davidmolony/HVDCDC/README.md

# HVDCDC
Hardware and firmware for stm32G030F6 based DCDC converter
