davidmolony/HVDCDC/HVDCDC/HVDCDC.pdf

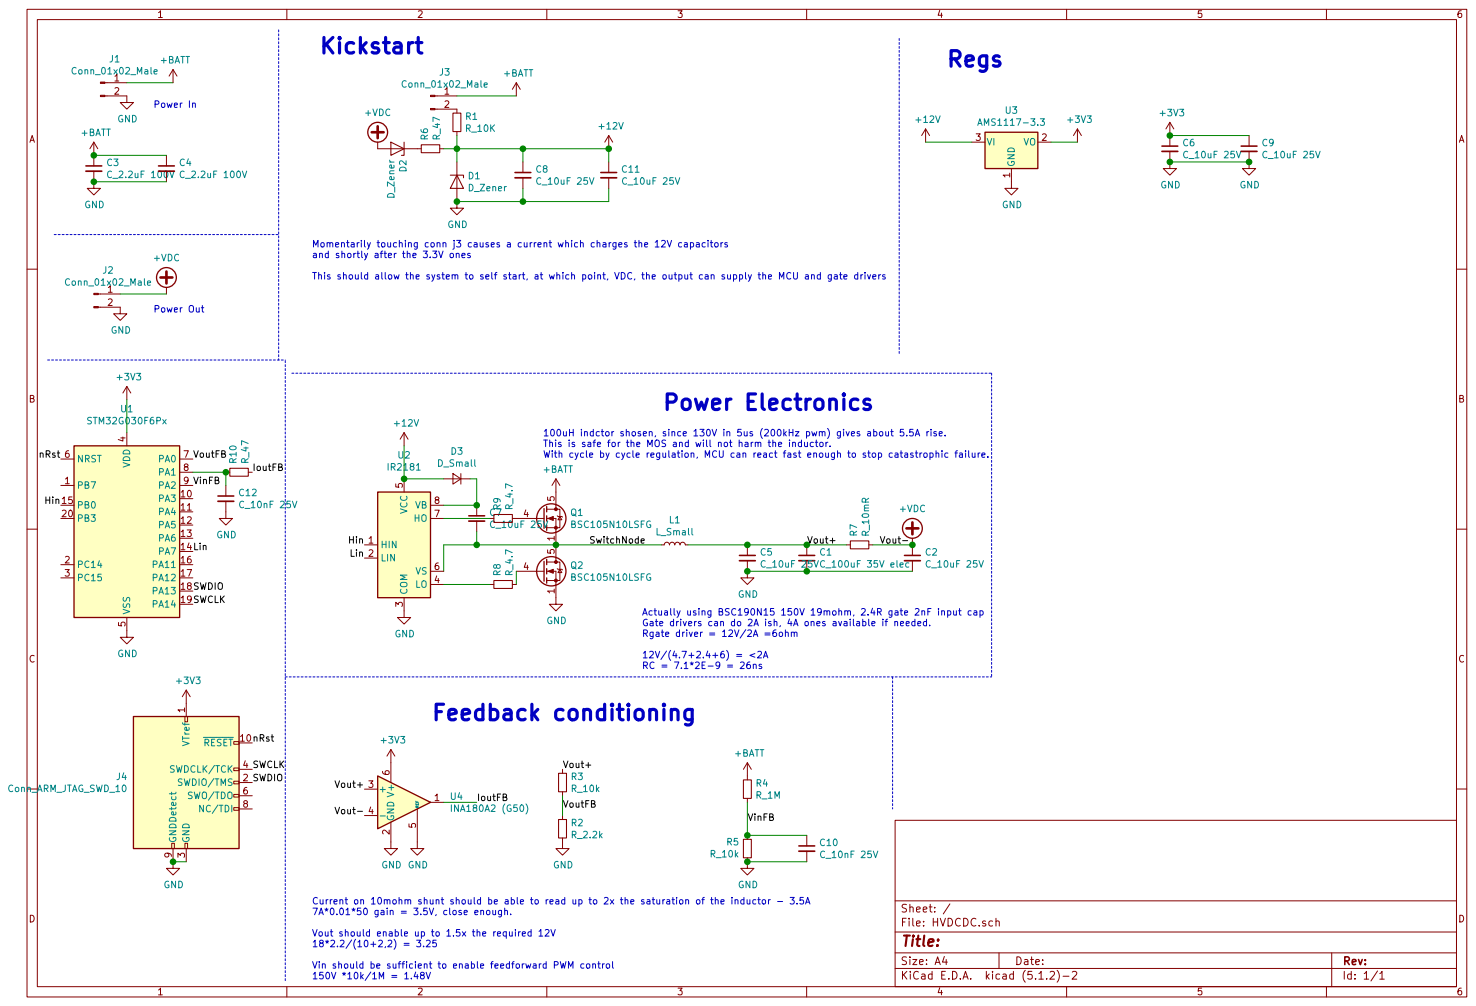
[picture p1: page 1]

Momentarily touching conn j3 causes a current which charges the 12V capacitors
and shortly after the 3.3V ones

12V/(4.7+2.4+6) = <2A RC = 7.1*2E-9 = 26ns 100uH indctor shosen, since 130V in 5us (200kHz pwm) gives about 5.5A rise. This is safe for the MOS and will not harm the inductor. With cycle by cycle regulation, MCU can react fast enough to stop catastrophic failure. R10 R_47 C12 C_10nF 25V GND

Actually using BSC190N15 150V 19mohm, 2.4R gate 2nF input cap Gate drivers can do 2A ish, 4A ones available if needed. Rgate driver = 12V/2A =6ohm

3 SWDCLK/TCK 4 SWO/TDO 6 NC/TDI 8 GNDDetect 9

Current on 10mohm shunt should be able to read up to 2x the saturation of the inductor - 3.5A
7A*0.01*50 gain = 3.5V, close enough.

Id: 1/1 Title: File: HVDCDC.sch Sheet: /

Vout should enable up to 1.5x the required 12V
18*2.2/(10+2,2) = 3.25 Vin should be sufficient to enable feedforward PWM control 150V *10k/1M = 1.48V
