davidmolony/HVDCDC/HVDCDC/HVDCDC.kicad_pcb

## KiCad design HVDCDC/HVDCDC.kicad_pcb (2023-01-25)

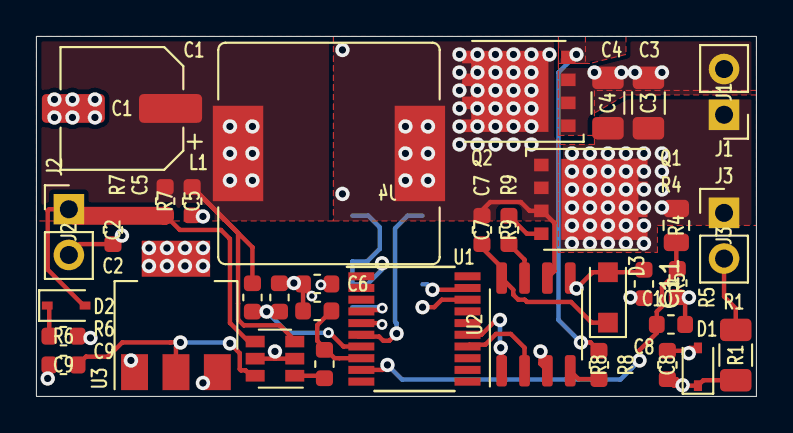
[picture p2: board HVDCDC.kicad_pcb from above]

Board: 4 copper layers, 40.0 x 20.0 mm, 36 parts (1 on the bottom side), 23 nets.

Parts:
C1: C_100uF 35V elec; CP_Elec_6.3x7.7
C2, C5, C6, C7, C8, C9, C11: C_10uF 25V; C_0603_1608Metric
C3, C4: C_2.2uF 100V; C_1206_3216Metric
C10, C12: C_10nF 25V; C_0603_1608Metric
D1, D2: D_Zener; D_SOD-323
D3: D_Small; D_SOD-123F
J1, J2, J3: Conn_01x02_Male; PinHeader_1x02_P2.54mm_Vertical
J4: Conn_ARM_JTAG_SWD_10; PinHeader_2x05_P1.27mm_Vertical_SMD
L1: L_Small; L_Bourns_SRR1210A
Q1, Q2: BSC105N10LSFG; TDSON-8-1
R1: R_10K; R_1206_3216Metric
R2: R_2.2k; R_0603_1608Metric
R3, R5: R_10k; R_0603_1608Metric
R4: R_1M; R_0805_2012Metric
R6, R10: R_47; R_0603_1608Metric
R7: R_10mR; R_0603_1608Metric
R8, R9: R_4.7; R_0603_1608Metric
U1: STM32G030F6Px; TSSOP-20_4.4x6.5mm_P0.65mm
U2: IR2181; SO-8_3.9x4.9mm_P1.27mm
U3: AMS1117-3.3; SOT-223-3_TabPin2
U4: INA180A2 (G50); SOT-23-6

Connections:
+3V3: C6.1, C9.1, J4.1, U1.4, U3.2, U4.6
+12V: C8.1, C11.1, D1.1, D3.2, R1.2, R6.2, U2.5, U3.3
+BATT: C3.1, C4.1, J1.1, J3.1, Q1.5, R4.1
+VDC: C2.1, D2.2, J2.1, R7.2, U4.4
/Hin: U1.15, U2.1
/IoutFB: R10.2, U4.1
/Lin: U1.14, U2.2
/SWCLK: J4.4, U1.19
/SWDIO: J4.2, U1.18
/SwitchNode: C7.2, L1.1, Q1.1, Q1.2, Q1.3, Q2.5, U2.6
/VinFB: C10.1, R4.2, R5.2, U1.9
/Vout+: C1.1, C5.1, L1.2, R3.1, R7.1, U4.3
/VoutFB: R2.1, R3.2, U1.7
/nRst: J4.10, U1.6
GND: C1.2, C2.2, C3.2, C4.2, C5.2, C6.2, C8.2, C9.2, C10.2, C11.2, C12.2, D1.2, J1.2, J2.2, J4.3, J4.5, J4.9, Q2.1, Q2.2, Q2.3, R2.2, R5.1, U1.5, U2.3, U3.1, U4.2, U4.5
unnamed: C7.1, D3.1, U2.8
unnamed: C12.1, R10.1, U1.8
unnamed: D2.1, R6.1
unnamed: J3.2, R1.1
unnamed: Q1.4, R9.2
unnamed: Q2.4, R8.2
unnamed: R8.1, U2.4
unnamed: R9.1, U2.7
