davidmolony/HVDCDC/Firmware/HVDCDC.ioc

Mcu.UserName=STM32G030F6Px
PA0.Signal=ADC1_IN0
PA1.Signal=ADC1_IN1
PA13.Signal=SYS_SWDIO
PA14-BOOT0.Signal=SYS_SWCLK
PA2.Signal=ADC1_IN2
PA7.Signal=TIM1_CH1N
PA8.Signal=S_TIM1_CH1
