davidmolony/HVDCDC/(commit log)

2022-10-10 Working ADC reads, PWM and interrupts
2023-01-25 Add hardware files
    [Calcs.ods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]
2023-01-31 Small changes to make this run at 90V
